jean-claudeF/BMS/README.md

# BMS
The aim of this project is to elaborate a battery mangement system based on a Raspi Pico controller

Git page: https://github.com/jean-claudeF/BMS

A first step to this is a 12 channel voltmeter, to measure the cell voltages (of a 12 cell battery):
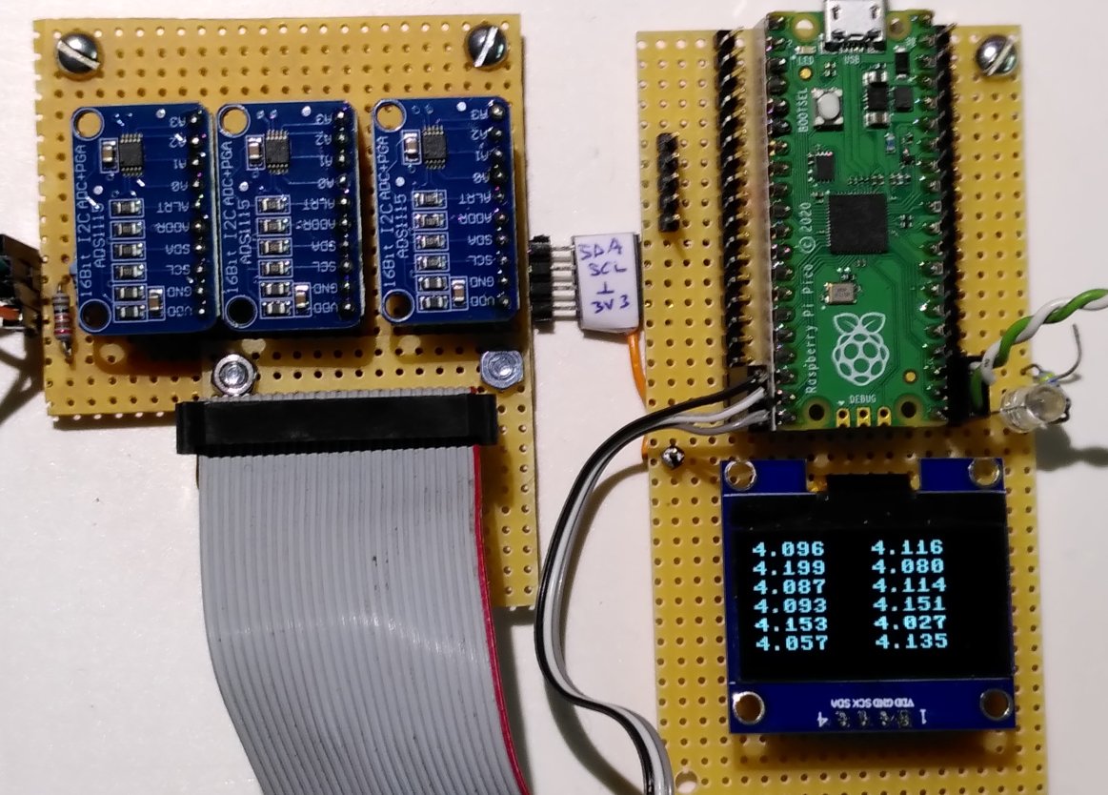
[picture p1: 12ch_voltmeter.jpg]


The first tests are run on a dummy battery:
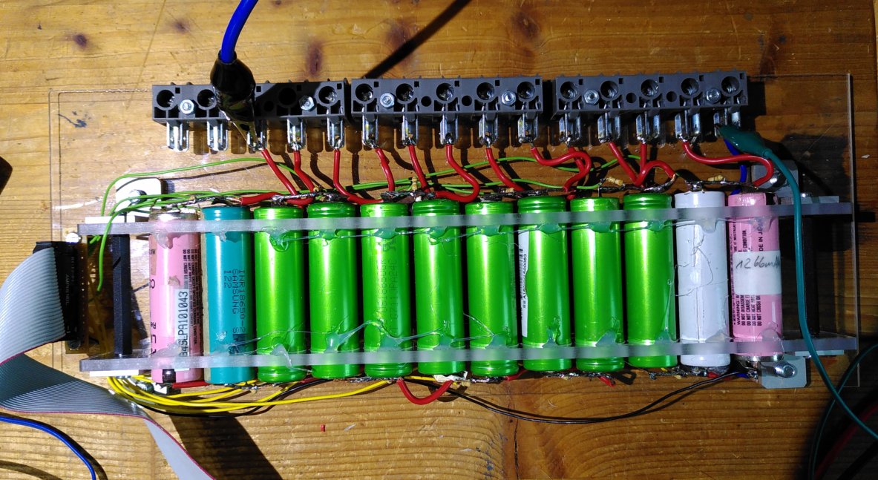
[picture p2: dummy_batterie.jpg]


This is work in progress and not ready yet!

The Raspi Pico needs some public libraries:

OLED-display:
https://github.com/robert-hh/SH1106

4 channel ADC ADS1115:
https://github.com/robert-hh/ads1x15
