jean-claudeF/BMS/hardware/12ch_voltmeter.sch

## KiCad design hardware/12ch_voltmeter.sch (2021-11-15)

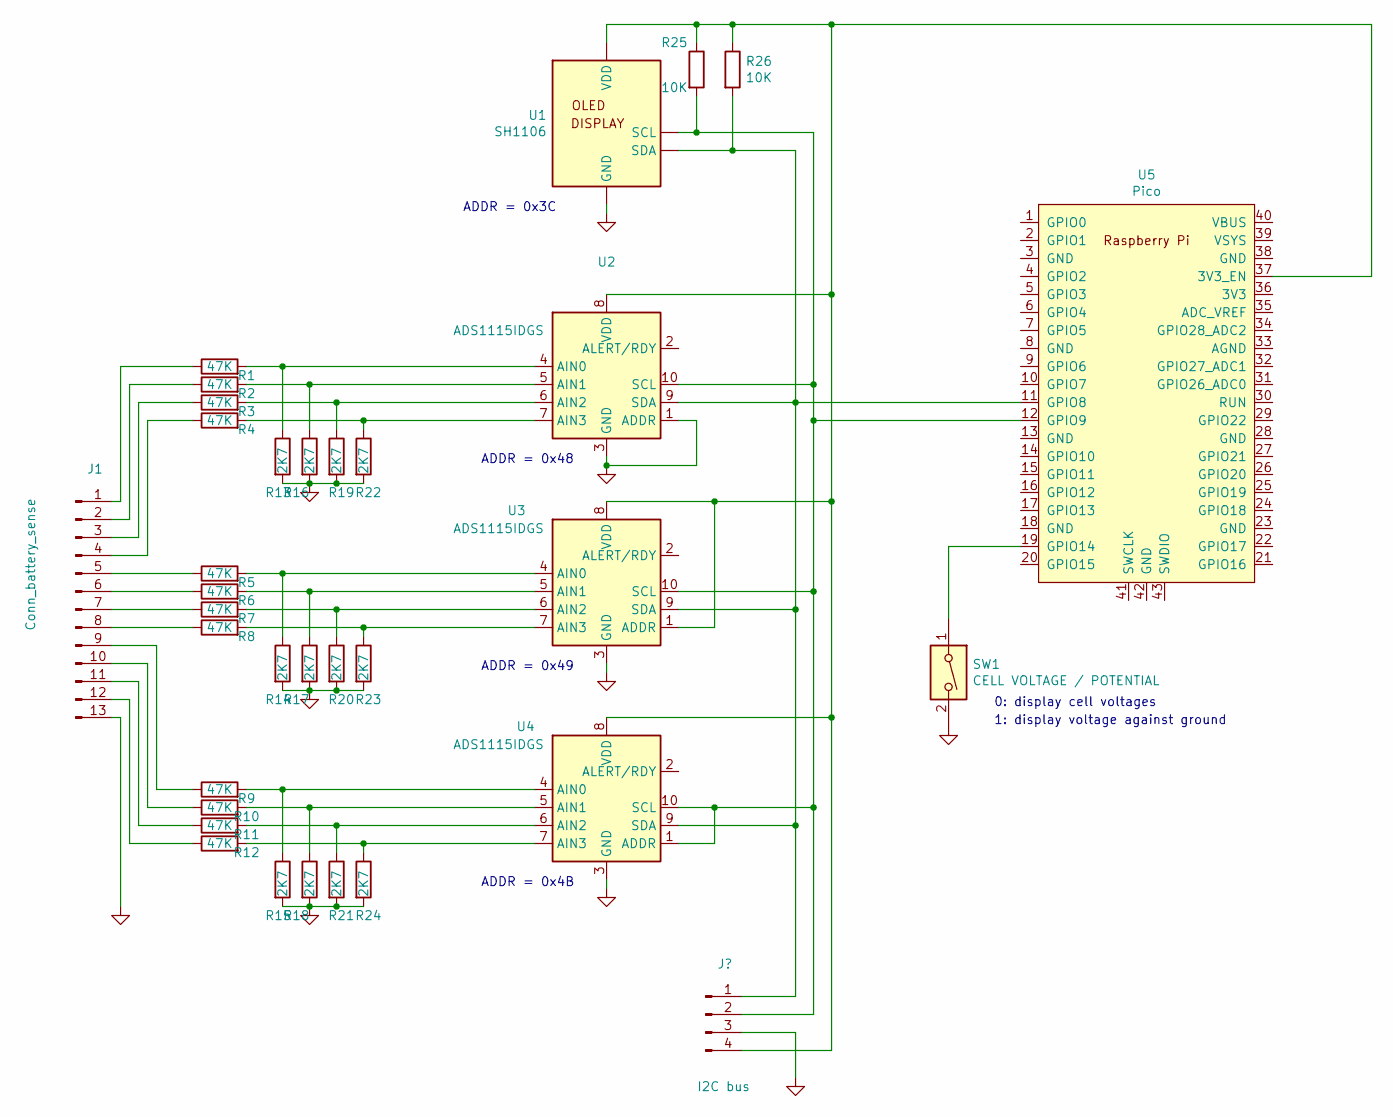
[picture p9: schematic 12ch_voltmeter.sch]

Parts:
J1: Conn_battery_sense
R1, R2, R3, R4, R5, R6, R7, R8, R9, R10, R11, R12: 47K
R13, R14, R15, R16, R17, R18, R19, R20, R21, R22, R23, R24: 2K7
R25, R26: 10K
SW1: CELL VOLTAGE / POTENTIAL
U1: SH1106
U2, U3, U4: ADS1115IDGS; TSSOP-10_3x3mm_P0.5mm
U5: Pico; RPi_Pico_SMD_TH

Connections:
GND: J1.13, R13.2, R14.2, R15.2, R16.2, R17.2, R18.2, R19.2, R20.2, R21.2, R22.2, R23.2, R24.2, SW1.2, U1.3 (GND), U2.1 (ADDR), U2.3 (GND), U3.3 (GND), U4.3 (GND)
unnamed: J1.1, R1.1
unnamed: J1.2, R2.1
unnamed: J1.3, R3.1
unnamed: J1.4, R4.1
unnamed: J1.5, R5.1
unnamed: J1.6, R6.1
unnamed: J1.7, R7.1
unnamed: J1.8, R8.1
unnamed: J1.9, R9.1
unnamed: J1.10, R10.1
unnamed: J1.11, R11.1
unnamed: J1.12, R12.1
unnamed: R1.2, R13.1, U2.4 (AIN0)
unnamed: R10.2, R18.1, U4.5 (AIN1)
unnamed: R11.2, R21.1, U4.6 (AIN2)
unnamed: R12.2, R24.1, U4.7 (AIN3)
unnamed: R5.2, R14.1, U3.4 (AIN0)
unnamed: R9.2, R15.1, U4.4 (AIN0)
unnamed: R2.2, R16.1, U2.5 (AIN1)
unnamed: R6.2, R17.1, U3.5 (AIN1)
unnamed: R3.2, R19.1, U2.6 (AIN2)
unnamed: R7.2, R20.1, U3.6 (AIN2)
unnamed: R4.2, R22.1, U2.7 (AIN3)
unnamed: R8.2, R23.1, U3.7 (AIN3)
unnamed: R25.1, R26.1, U1.8 (VDD), U2.8 (VDD), U3.1 (ADDR), U3.8 (VDD), U4.8 (VDD), U5.37 (3V3_EN)
unnamed: R25.2, U1.10 (SCL), U2.10 (SCL), U3.10 (SCL), U4.1 (ADDR), U4.10 (SCL), U5.12 (GPIO9)
unnamed: R26.2, U1.9 (SDA), U2.9 (SDA), U3.9 (SDA), U4.9 (SDA), U5.11 (GPIO8)
unnamed: SW1.1, U5.19 (GPIO14)

Notes on the sheet:
ADDR = 0x48
ADDR = 0x49
ADDR = 0x4B
0: display cell voltages
1: display voltage against ground
ADDR = 0x3C
